davi-domo/CANDLE-BLE/README.md

# <p align="center">CANDLE-BLE</p>
  
CANDLE-BLE est une télécommande bluetooth LE permettant d'envoyer des raccourcis claviers au logiciel CANDLE pour contrôler une CNC sous GRBL

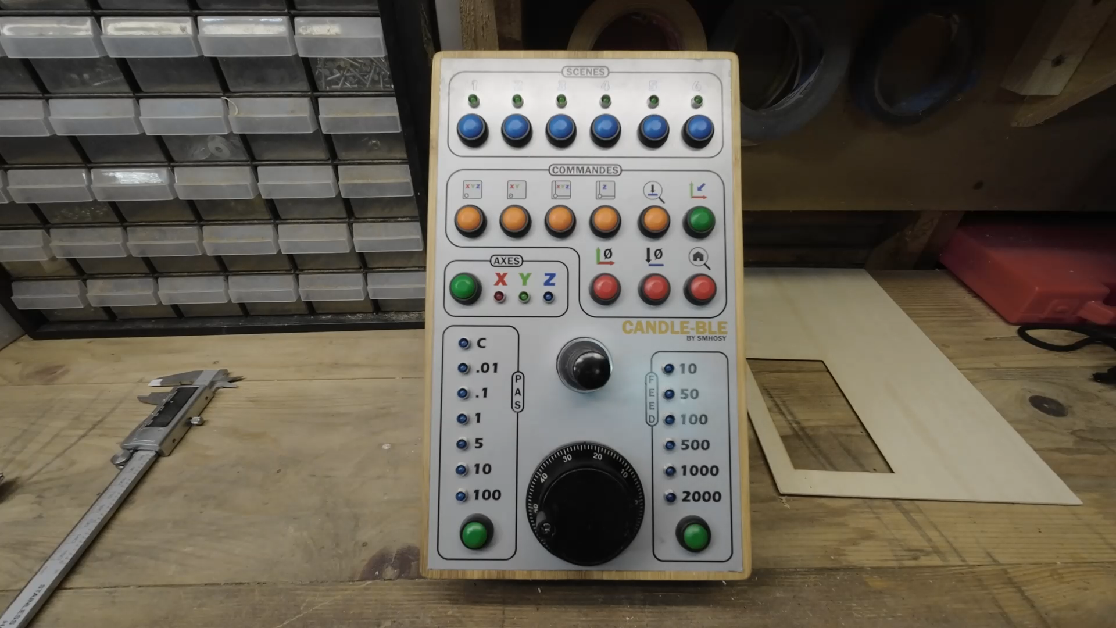
[picture p1: image/Candle-ble en situation.png]


[Vidéos Youtube détaillant le projet ](https://www.youtube.com/watch?v=rjfkb--jz7Q)

## 🙇 Author
#### SMHOSY (David AUVRÉ)
- YouTube: [@SMHOSY](https://www.youtube.com/@SMHOSY)
- Instagram: [@SMHOSY](https://www.instagram.com/smhosy/)

## ➤ License
Distributed under the MIT License. See [LICENSE](https://github.com/davi-domo/CANDLE-BLE/tree/main?tab=MIT-1-ov-file#readme) for more information.
