davi-domo/CANDLE-BLE/image/Interieur.JPG

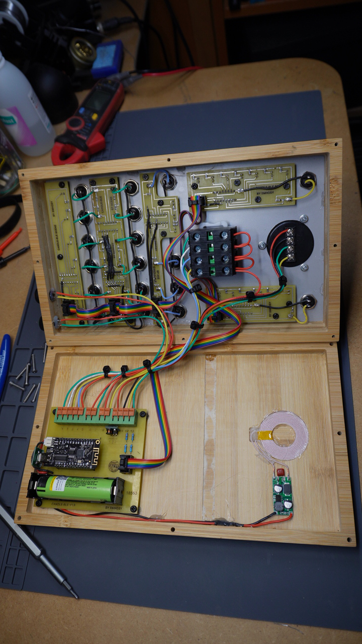
image/Interieur.JPG
