davi-domo/CANDLE-BLE/Schema/CANDLE-BLE SCHEMA.pdf

A | B | C | D | E | F | G | H | I | J | K | L | M | N

1

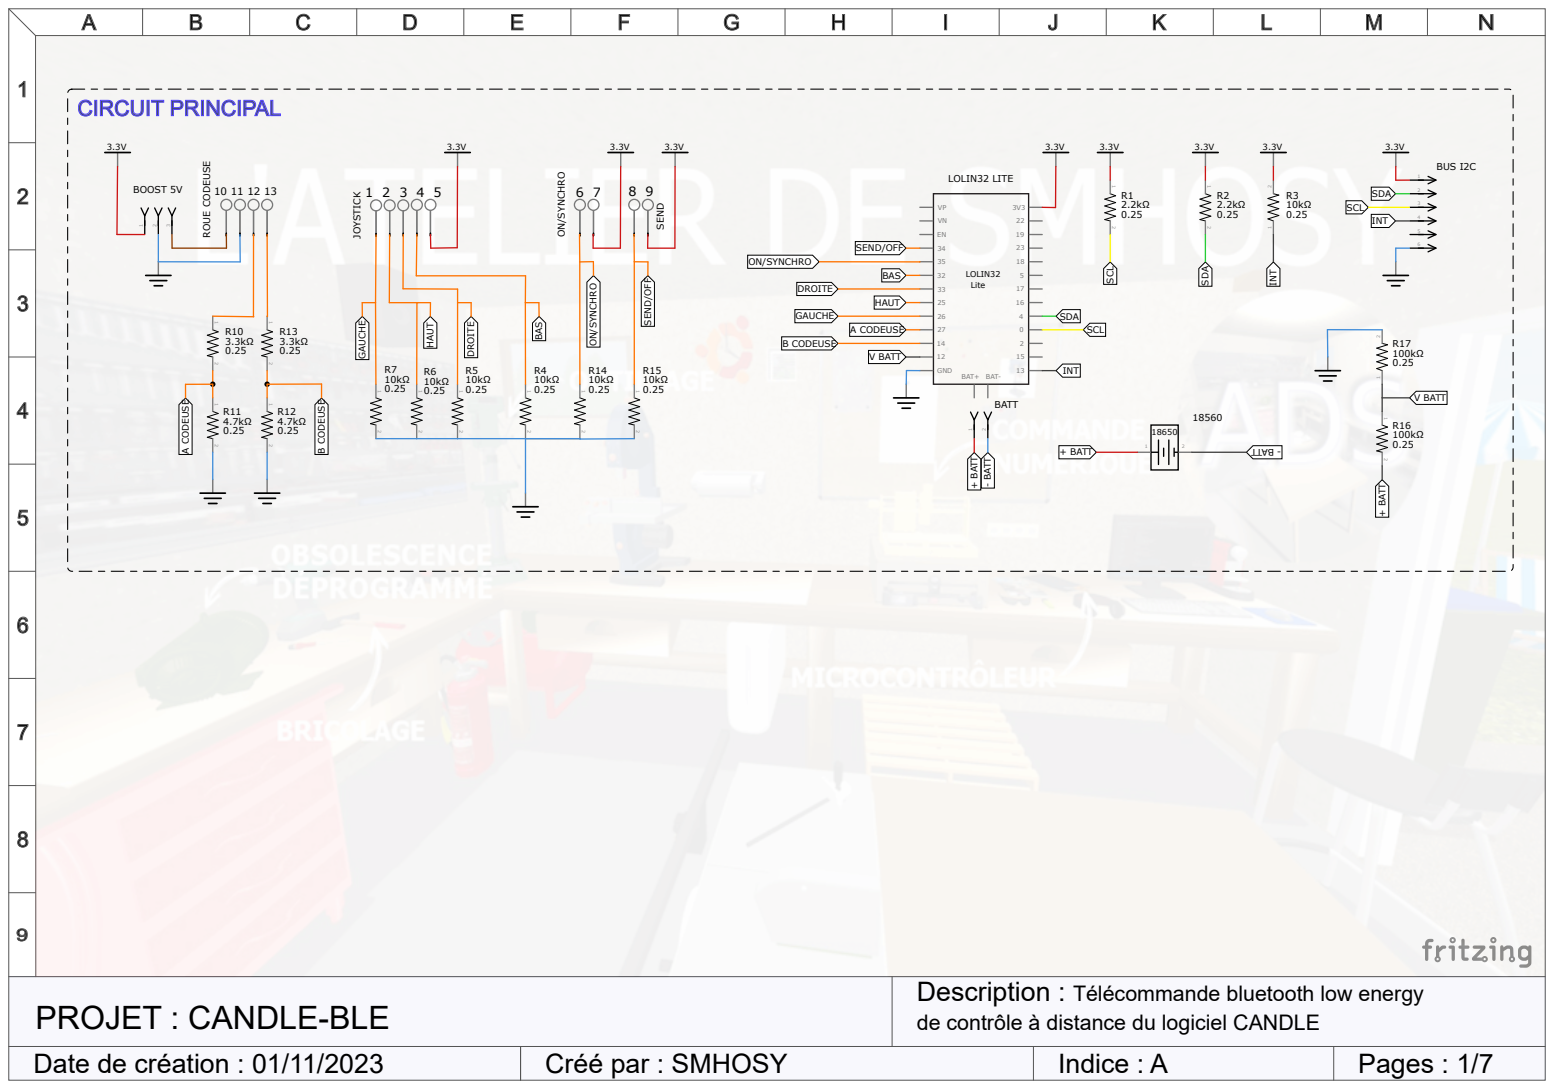
[picture p3: page 1]

de contrôle à distance du logiciel CANDLE

1

2

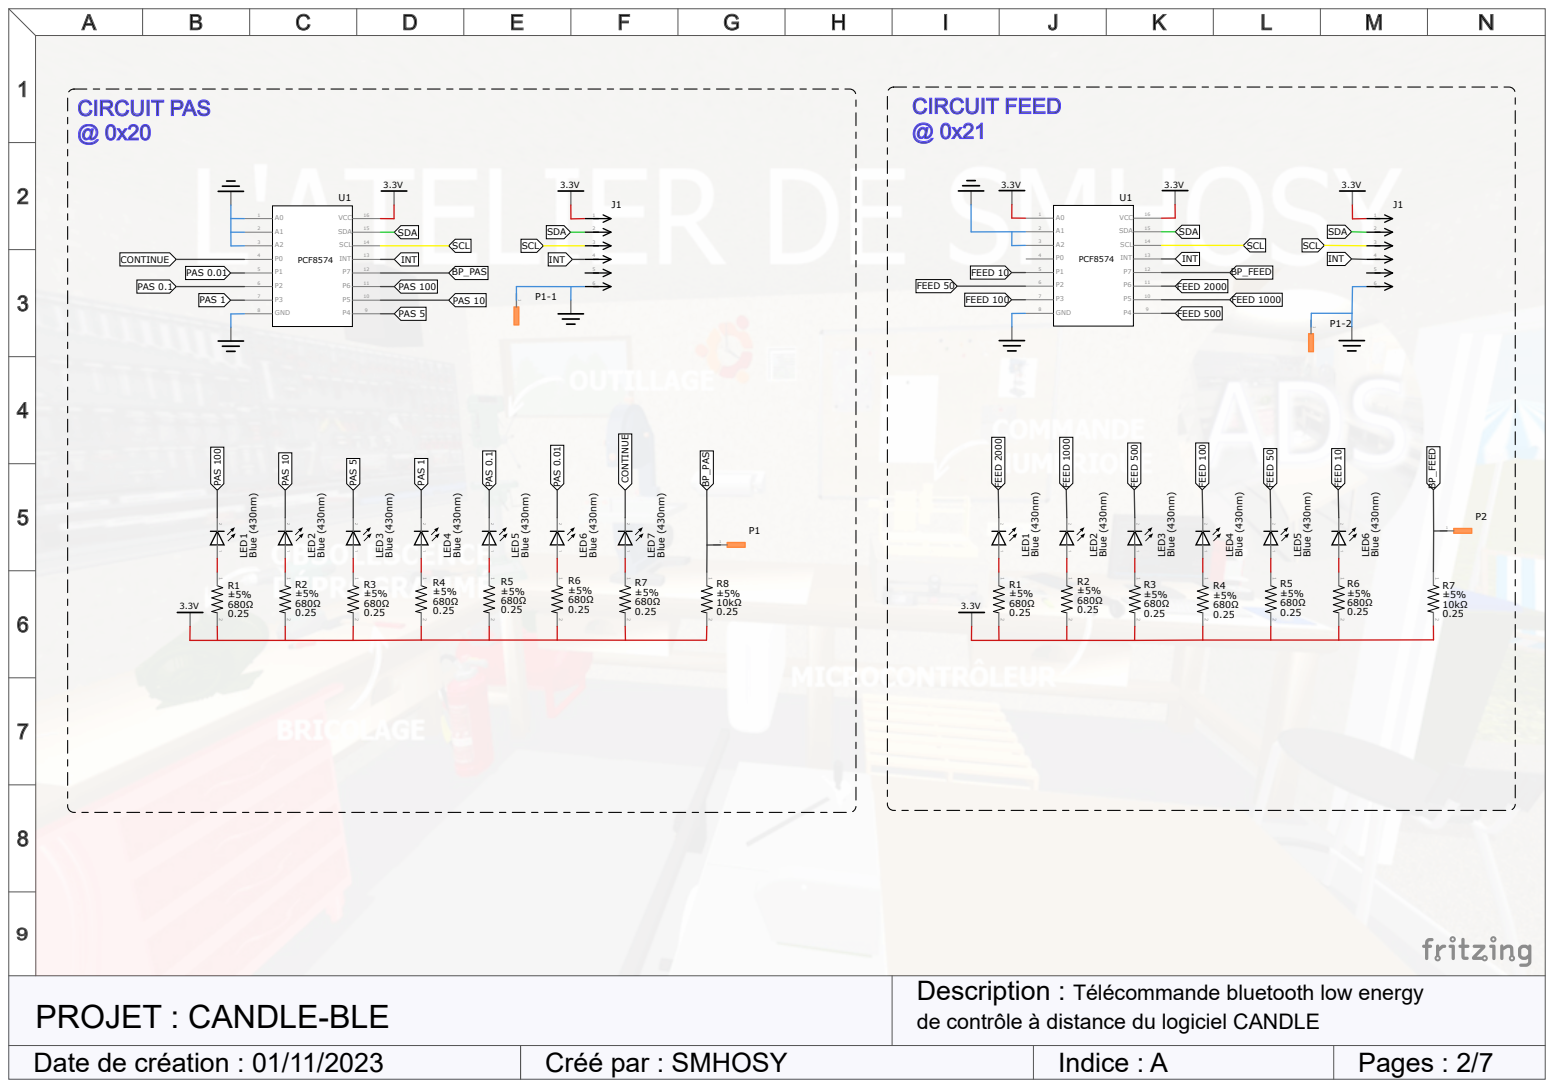
[picture p4: page 2]

1

2

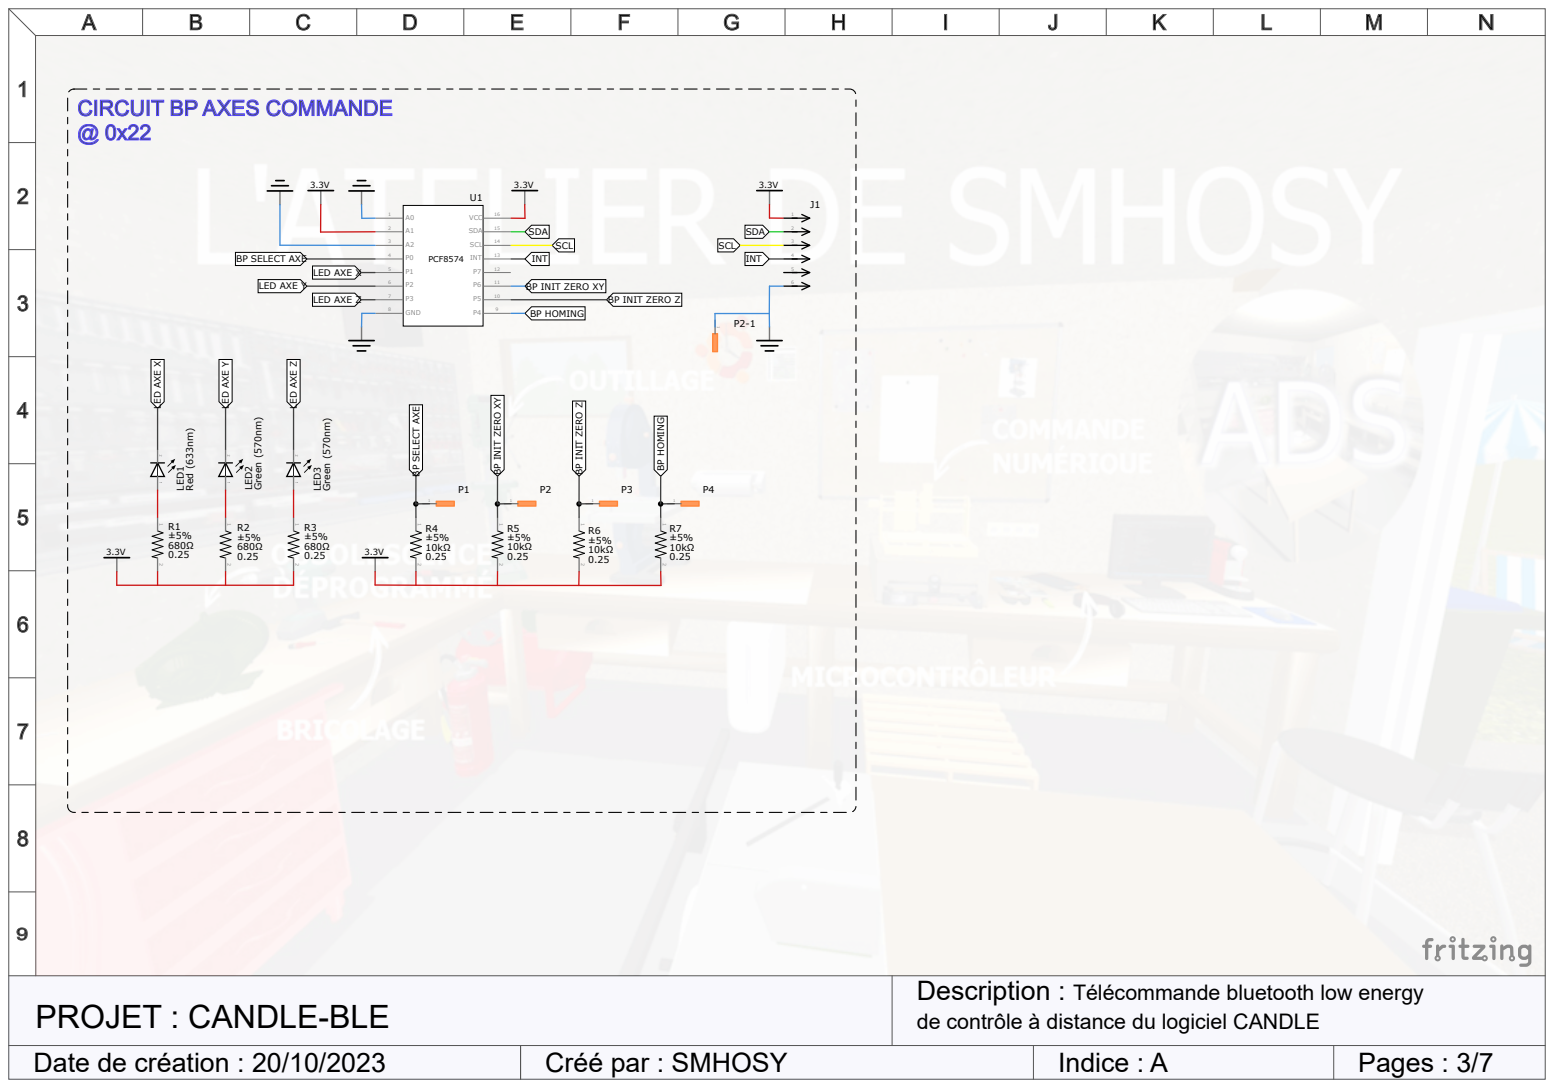
[picture p5: page 3]

CIRCUIT BP AXES COMMANDE

BP INIT ZERO XY

1

2

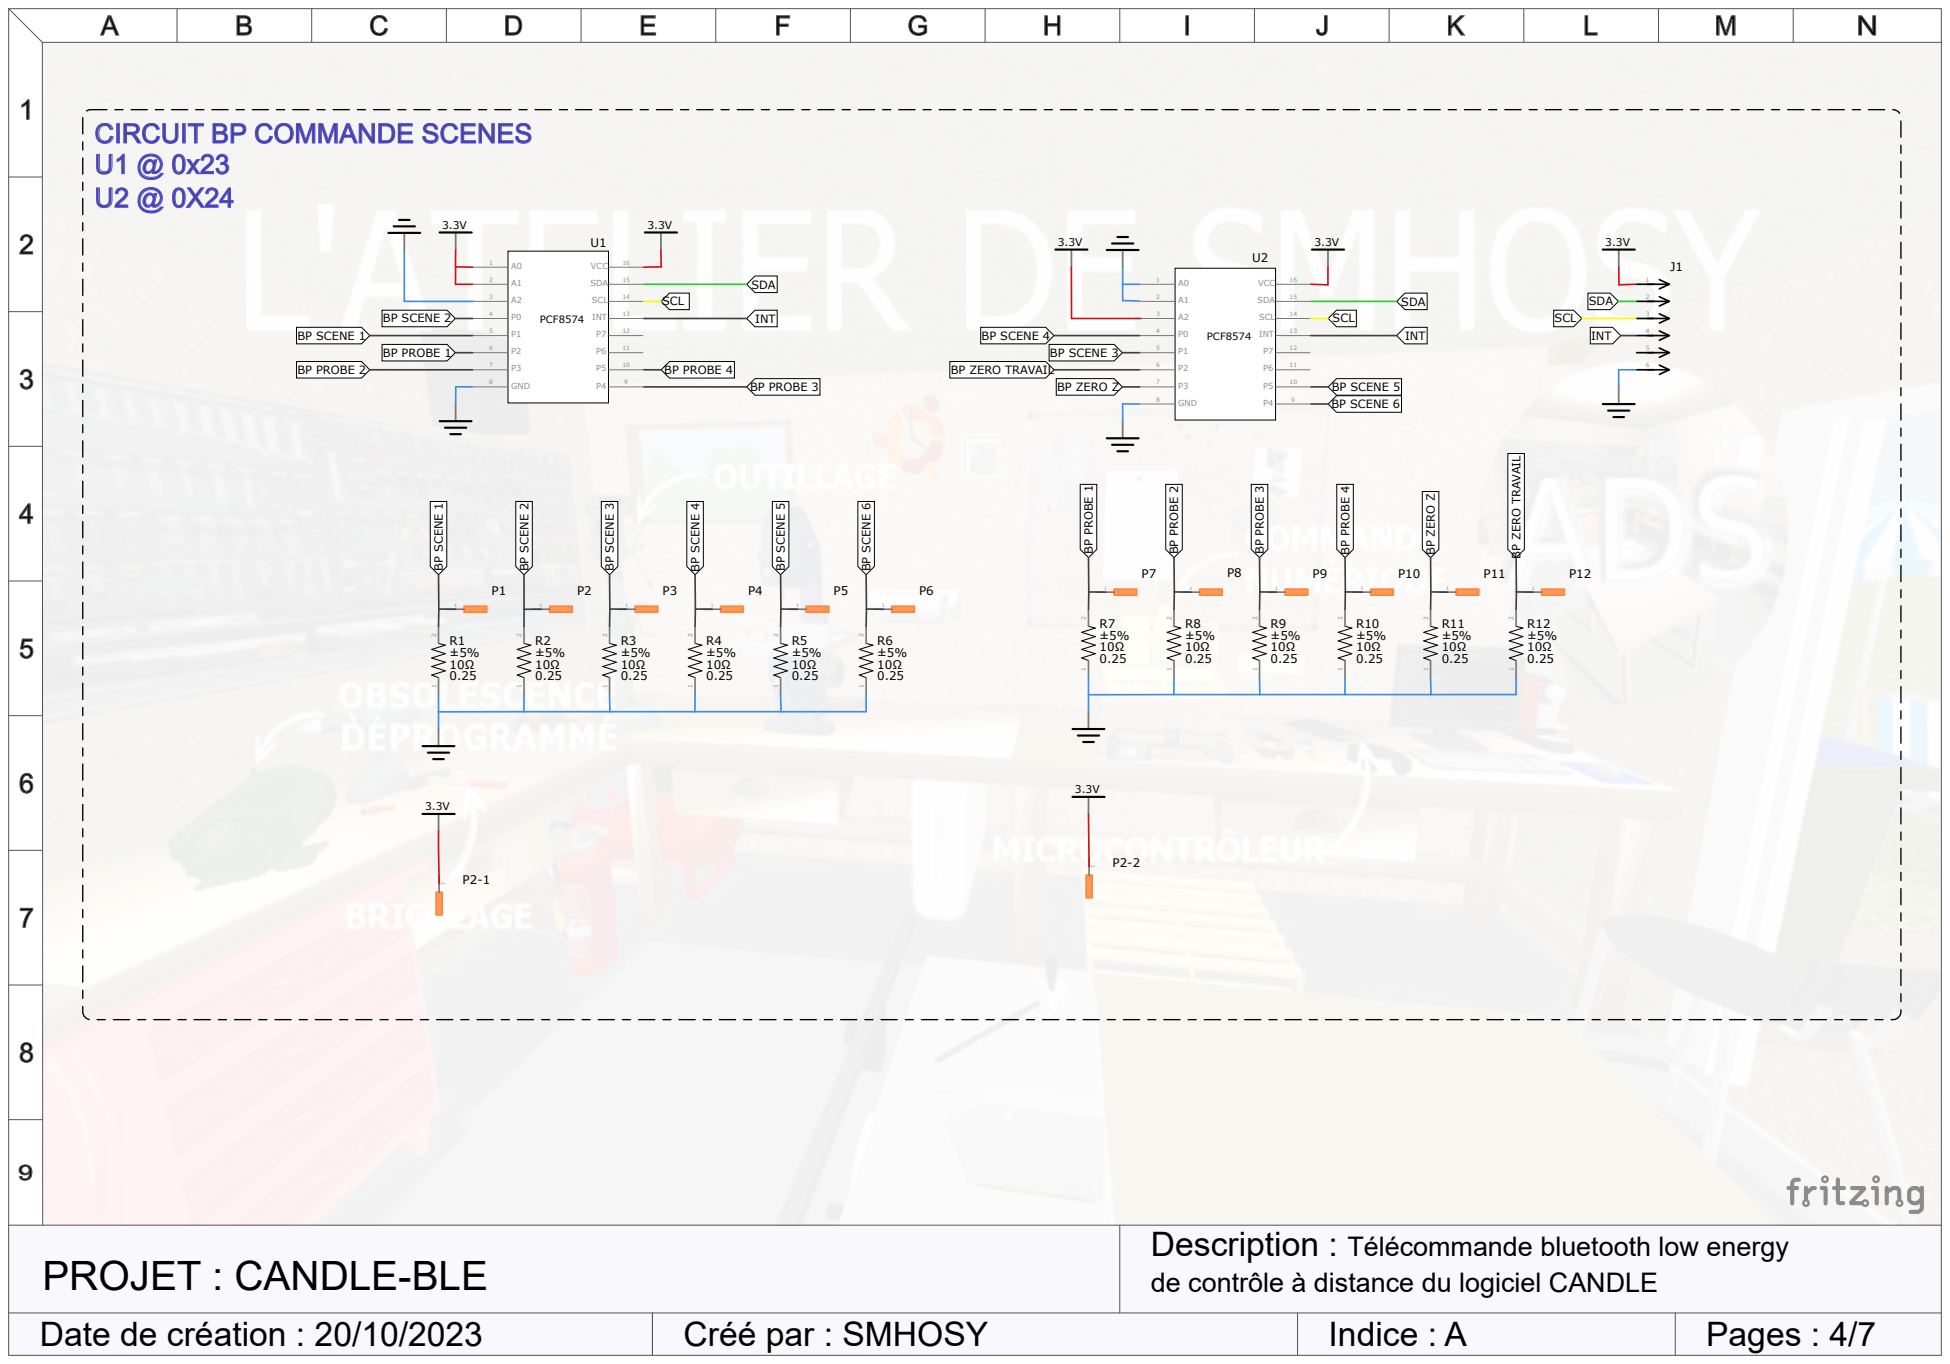
[picture p6: page 4]

1

2

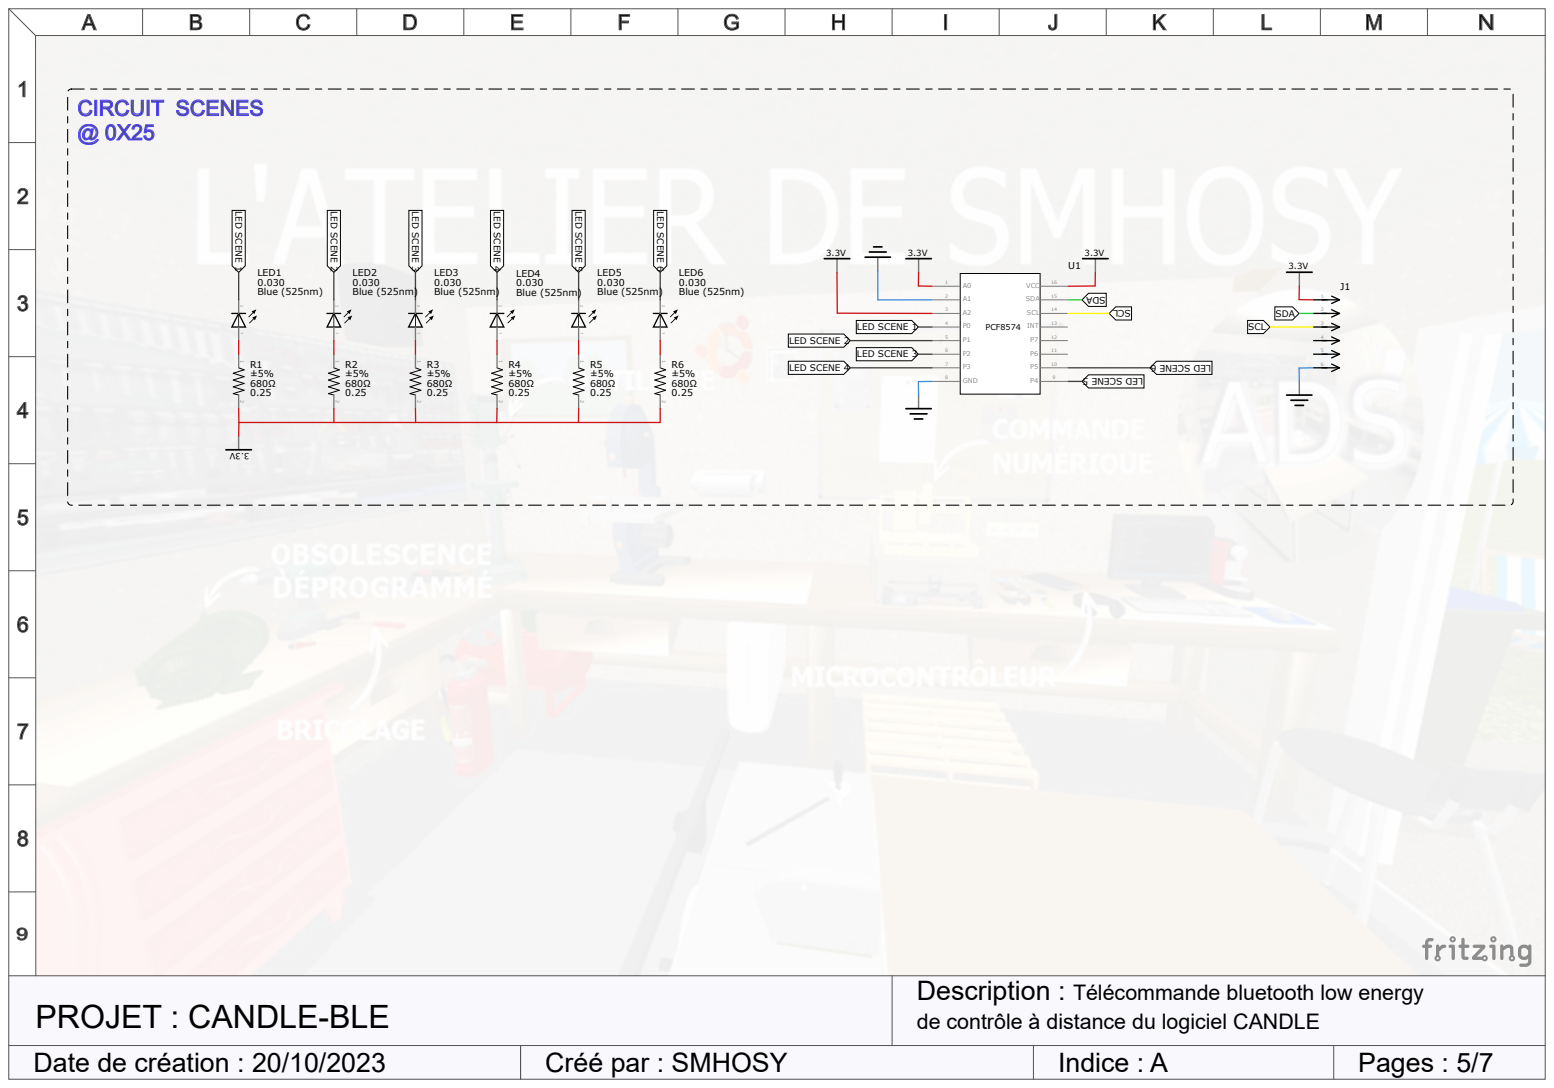
[picture p7: page 5]

1

2

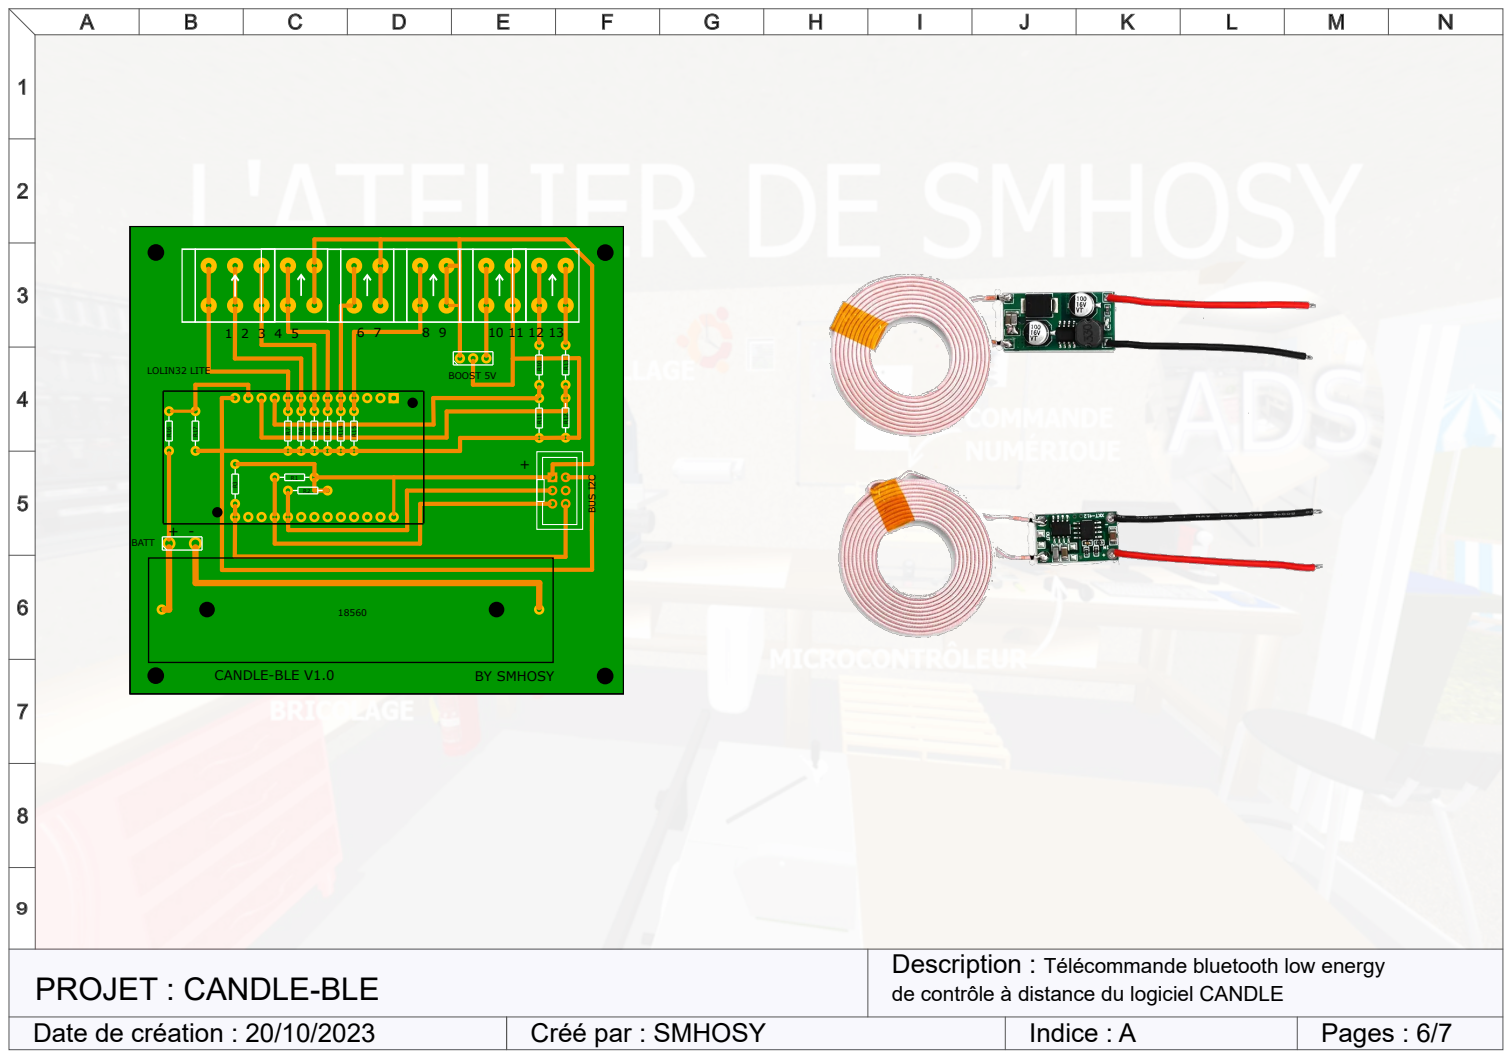
[picture p8: page 6]

1

2

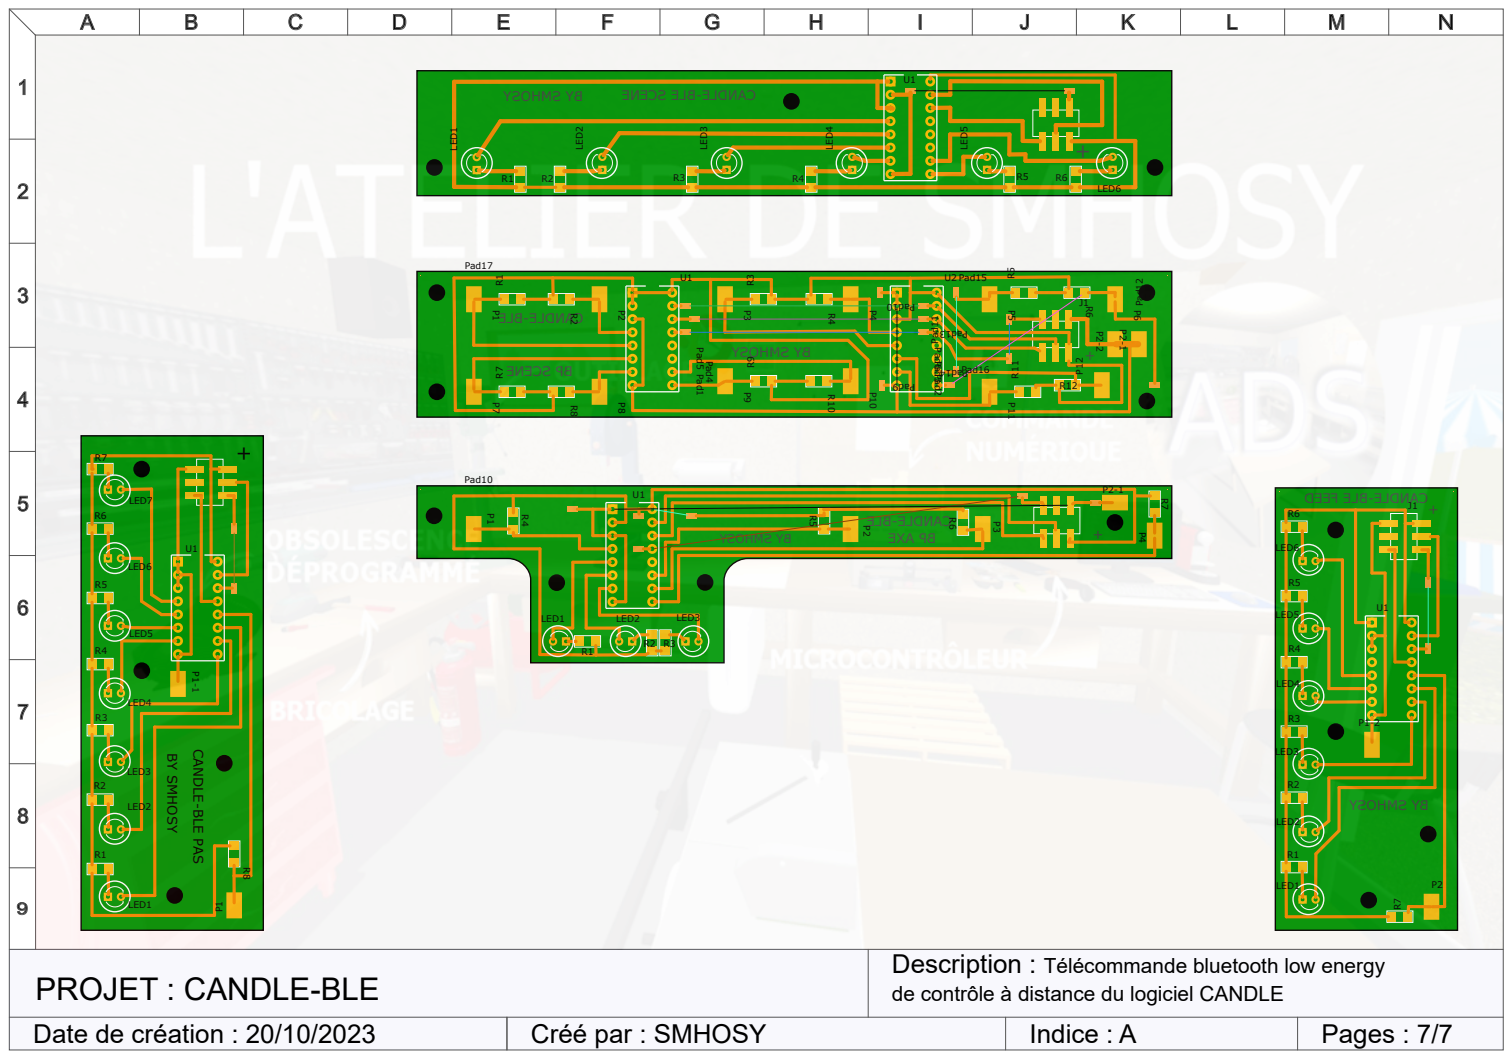
[picture p9: page 7]
