davi-domo/CANDLE-BLE/(list of files, drawings)

Other design files:
Fritzing/CANDLE-BLE-BASE.fzz
Fritzing/CANDLE-BLE-BP-AXE-CDM.fzz
Fritzing/CANDLE-BLE-BP-SCENE-CDM.fzz
Fritzing/CANDLE-BLE-FEED.fzz
Fritzing/CANDLE-BLE-PAS.fzz
Fritzing/CANDLE-BLE-SCENES.fzz
