davi-domo/CANDLE-BLE/Firmware/include/config.h

/* fichier de configuration de CANDLE-BLE */

// detail du projet

const char *ver = "1.00";
const char *modif = "13/12/2023";

// Nom du périphérique bluetooth
const char *name_ble = "CANDLE-BLE";

// gestion auto_off en secondes
#define time_auto_off 3600 // 1h en secondes
