davi-domo/CANDLE-BLE/(commit log)

2023-12-31 Correction de bug setBatteryLevel avec nimble
2023-12-31 Correction de bug time_send_bat
2023-12-31 Modification de l'enregistrement time_send_bat
